ChadsArcade/Mame-Spinner/Spinner4-small.jpg

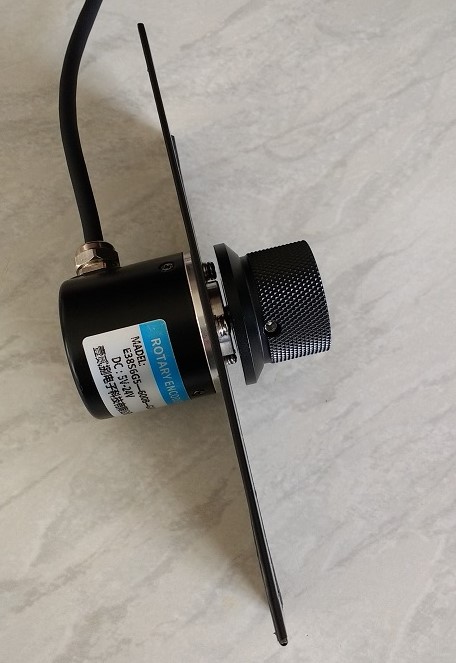
Spinner4-small.jpg
