ChadsArcade/Mame-Spinner/(commit log)

2020-01-12 Initial uploads, USB and PS2 versions
    Arduino UNO, USB version requires that you have a 16U2 USB controller flashed with USB Mouse firmware. CH340G controllers on most cheap clones will not work!
    I could not get the PS/2 version to work reliably, code posted for reference
    [PS2_Spinner_ISRRev3.ino]
2020-01-12 Initial upload, USB version
    USB version, requires you to reflash the USB controller to a USB Mouse HID device
2020-01-12 Added pictures
    Pics of the Spinner, with mounting plate for Tempest mounts
2020-01-19 Added code for Arduino Pro Micro
    Use this version for the easiest way to get a USB spinner working under Windows/Linux
2020-01-19 Added pictures
    Pictures of the Spinner assembly
2020-01-29 Added code for HoodLoader2 Spinner for a UNO
    Code for an Arduino UNO running HoodLoader2, this is flashed to the 16u2 CPU
